yassinebkr/dmx-controller/docs/xiaorp2040_pinout.jpg

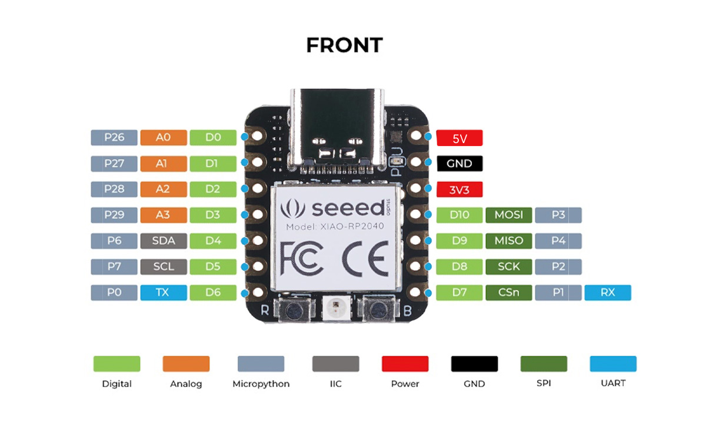
docs/xiaorp2040_pinout.jpg
