yassinebkr/dmx-controller/docs/Fiche presentation projet E62 - 0 Extensions DMX.pdf

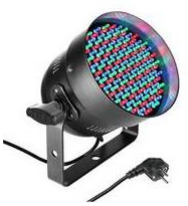
[picture p2: figure]
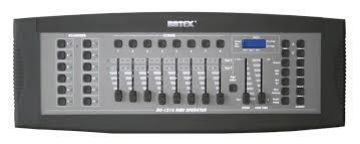
[picture p3: figure]

BTS CIEL : Dossier de validation de projet U62

BTS CIEL Option Electronique et Réseaux Projet technique : U62 | Session 2026
Etablissement : Lycée Jules FERRY - Cannes | Académie : ☑ Nice ☐ Corse

## Titre du projet Extensions DMX

Nouveau projet : ☐Oui ☑Non Partenaire professionnel

Raison sociale

Professeurs responsables

- KERNEN Elisabeth
- BENDIAF Mohamed
- ROQUES Aurélien

____________________________________________________________________________________

### Présentation générale du système supportant le projet :

Les éclairages de scènes utilisent différents
équipements électriques qui peuvent être
commandés grâce à un bus DMX.

____________________________________________________________________________________

### Analyse de l’existant :

L’ensemble des commandes est assurée par une
console DMX

____________________________________________________________________________________

### Expression du besoin :

Le client désire développer des extensions qui vont permettre :

- De réaliser des commandes individuelles de chaque éléments qui constitue le portique
- De rajouter un panneau lumineux commandé en DMX
- De connaitre la consommation instantanée et globale de l’installation
- De tester le bus DMX et d’analyser la trame

## Parties non étudiées en 2023

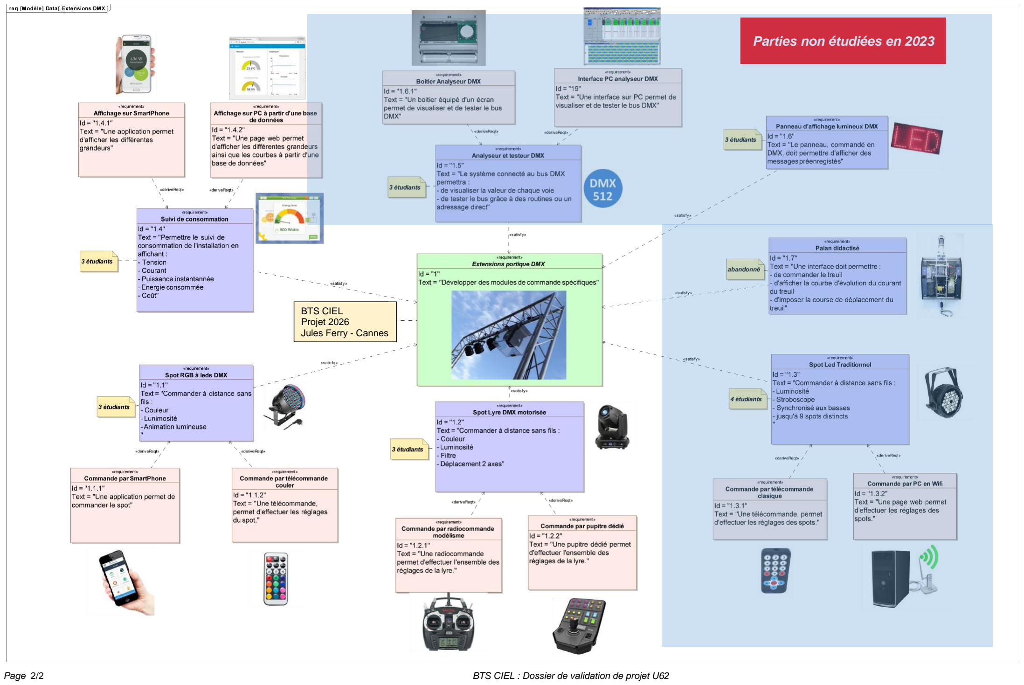
[picture p4: page 2]

Page 2/2 | BTS CIEL : Dossier de validation de projet U62

BTS CIEL
Projet 2026
Jules Ferry - Cannes
