yassinebkr/dmx-controller/tests/test_combined.py

# test_combined.py -- OLED + Joystick + Resistor-ladder buttons combined
# ======================================================================
# Shows joystick + button-ladder state on the OLED using fast direct
# framebuffer writes.
#
# Encoder is INTENTIONALLY excluded from this test. Rationale:
# test_ec11.py confirms the EC11 decodes cleanly on its own with simple
# digitalio polling at ~1 ms. Combining it with the joystick here pushes
# OLED redraws into every loop iteration (joystick ADC values change
# constantly), which stretches each iteration to ~10-15 ms -- longer
# than one encoder A/B phase, so quadrature direction becomes unreliable.
# The real DMX controller UI updates on slower events (menu changes,
# XBee replies, button presses) rather than continuous analog values, so
# the encoder will get the timing it needs in the main application. This
# test only validates joystick + buttons + OLED coexistence.
#
# Requires: adafruit_ssd1306.mpy in lib/, font5x8.bin at CIRCUITPY root
# Wiring: A0=JoyX, A1=JoyY, A2=JoyZ, A3=Buttons, D4=SDA, D5=SCL
# Calibration: run test_joystick.py first to get CAL_X/Y/Z values

import board
import busio
import analogio
import time
import adafruit_ssd1306

# -- Setup -------------------------------------------------------------
# 1MHz I2C -- SSD1306 handles it (84 FPS raw transfer proven)
i2c = busio.I2C(scl=board.D5, sda=board.D4, frequency=1_000_000)
oled = adafruit_ssd1306.SSD1306_I2C(128, 64, i2c, addr=0x3C)

joy_x = analogio.AnalogIn(board.A0)
joy_y = analogio.AnalogIn(board.A1)
joy_z = analogio.AnalogIn(board.A2)
btn_adc = analogio.AnalogIn(board.A3)

# -- Load font ---------------------------------------------------------
try:
    with open("font5x8.bin", "rb") as f:
        raw = f.read()
    # font5x8.bin may have a 2-byte header (1282 bytes instead of 1280)
    if len(raw) == 1282:
        FONT = raw[2:]
    else:
        FONT = raw
except OSError:
    print("ERROR: font5x8.bin not found on CIRCUITPY root!")
    raise SystemExit

# -- Fast framebuffer text ---------------------------------------------
buf = oled.buf
BUF_START = 0

def fast_text(text, x, page):
    """Write text directly to framebuffer -- 13x faster than oled.text()."""
    offset = BUF_START + page * 128 + x
    for ch in text:
        idx = ord(ch) * 5
        if offset + 5 > len(buf):
            break
        buf[offset] = FONT[idx]
        buf[offset + 1] = FONT[idx + 1]
        buf[offset + 2] = FONT[idx + 2]
        buf[offset + 3] = FONT[idx + 3]
        buf[offset + 4] = FONT[idx + 4]
        offset += 6  # 5px char + 1px gap

def clear_pages(start, end):
    """Clear a range of pages (8px rows each)."""
    begin = BUF_START + start * 128
    stop = min(BUF_START + (end + 1) * 128, len(buf))
    for i in range(begin, stop):
        buf[i] = 0

# -- Joystick calibration (from test_joystick.py) ---------------------
CAL_X = (489, 31979, 63522)
CAL_Y = (384, 31492, 63666)
CAL_Z = (438, 3490, 36000)
DEADZONE_PCT = 8

# -- Button thresholds (resistor ladder on A3, 2.2k pull-up) ---------
BUTTONS = [
    ("B1", 0,     2978),
    ("B2", 2979,  9626),
    ("B3", 9627,  16887),
    ("B4", 16888, 23523),
    ("B5", 23524, 31339),
    ("B6", 31340, 39005),
    ("B7", 39006, 45707),
    ("B8", 45708, 57525),
]
NO_PRESS = 57525

# -- Helpers -----------------------------------------------------------

def read_joy(pin):
    return pin.value

def identify_button(val):
    for name, low, high in BUTTONS:
        if low <= val <= high:
            return name
    return "---" if val > NO_PRESS else "???"

def map_cal(raw, cal):
    """Map raw ADC to -99..+99 using (min, center, max) calibration."""
    cal_min, cal_center, cal_max = cal
    range_low = cal_center - cal_min
    range_high = cal_max - cal_center
    dz_low = int(range_low * DEADZONE_PCT / 100)
    dz_high = int(range_high * DEADZONE_PCT / 100)

    if cal_center - dz_low <= raw <= cal_center + dz_high:
        return 0
    if raw < cal_center - dz_low:
        effective = cal_center - dz_low - raw
        full_range = range_low - dz_low
        return max(-99, -int(effective * 99 / full_range)) if full_range > 0 else 0
    else:
        effective = raw - (cal_center + dz_high)
        full_range = range_high - dz_high
        return min(99, int(effective * 99 / full_range)) if full_range > 0 else 0

def num_to_str(n):
    """Format number as +XX or -XX with padding."""
    if n >= 0:
        s = "+" + str(n)
    else:
        s = str(n)
    while len(s) < 4:
        s = " " + s
    return s

# -- Page layout -------------------------------------------------------
PG_HEAD = 0
PG_SEP  = 1
PG_XY   = 2
PG_Z    = 3
PG_DIR  = 4
PG_BTN  = 7

# -- Draw static header (once) ----------------------------------------
clear_pages(0, 7)
fast_text("DMX Controller", 0, PG_HEAD)
fast_text("----------------", 0, PG_SEP)
oled.show()

# -- Main loop ---------------------------------------------------------
print("Combined test (joystick + buttons + OLED) -- Ctrl+C to stop")

press_count = 0
last_btn = "---"

try:
    while True:
        btn = identify_button(btn_adc.value)
        if btn != "---" and btn != "???" and last_btn == "---":
            press_count += 1
        last_btn = btn

        jx = map_cal(read_joy(joy_x), CAL_X)
        jy = map_cal(read_joy(joy_y), CAL_Y)
        jz = map_cal(read_joy(joy_z), CAL_Z)

        # Clear and redraw dynamic pages
        clear_pages(PG_XY, PG_BTN)

        # Joystick XY
        fast_text("X:" + num_to_str(jx) + " Y:" + num_to_str(jy), 0, PG_XY)

        # Z rotation with bar
        zabs = abs(jz) // 10
        if jz > 0:
            fast_text("Z: CW  " + "=" * zabs, 0, PG_Z)
        elif jz < 0:
            fast_text("Z: CCW " + "=" * zabs, 0, PG_Z)
        else:
            fast_text("Z: ---", 0, PG_Z)

        # Direction
        dx = "R" if jx > 15 else ("L" if jx < -15 else "-")
        dy = "U" if jy > 15 else ("D" if jy < -15 else "-")
        fast_text("Dir: " + dx + " " + dy, 0, PG_DIR)

        # Button
        fast_text("Btn:" + btn + " #" + str(press_count), 0, PG_BTN)

        oled.show()

        time.sleep(0.001)

except KeyboardInterrupt:
    clear_pages(0, 7)
    fast_text("Test done!", 0, 2)
    fast_text("Btn presses: " + str(press_count), 0, 3)
    oled.show()
    print("\nDone. " + str(press_count) + " btn presses.")
