yassinebkr/dmx-controller/(commit log)

2026-03-18 Initial commit: test scripts for OLED + button ladder
    - test_oled.py: SSD1306 I2C display test (fill, text, shapes, counter)
    - test_buttons.py: ADC raw monitor + threshold-based detection
    - test_combined.py: integrated OLED + button display
    - README with full pin budget and resistor ladder specs
2026-03-18 added datasheets and docs
    [XIAO-RP2040-pinout_sheet.xlsx]
2026-03-18 Add joystick test + update combined test
    - test_joystick.py: raw monitor (Phase 1) + mapped values with deadzone (Phase 2)
    - compass direction labels, -100 to +100 mapping
    - test_combined.py: now includes joystick (X/Y/Z mapped) + buttons + OLED
    - direction indicator, press counter, serial + OLED output
    - Joystick on A0/A1/A2, buttons on A3, OLED on D4/D5
2026-03-18 Fix joystick: calibration routine + asymmetric mapping
    Joystick pots don't center at half-VCC and ranges are asymmetric.
    test_joystick.py now has 3 phases:
    Phase 1: raw monitor (10s)
    Phase 2: auto-calibration (rest=center, then move to extremes)
    Phase 3: mapped output using actual min/center/max
    test_combined.py: uses CAL_X/Y/Z tuples (min, center, max)
    - paste values from test_joystick.py Phase 2
    - deadzone as % of range per side (8% default)
    - Z axis shows CW/CCW with bar indicator
    [test_combined.py, test_joystick.py]
2026-03-18 Set calibrated joystick values from hardware test
    CAL_X = (489, 31979, 63522)
    CAL_Y = (384, 31492, 63666)
    CAL_Z = (438, 3490, 46071)
    Note: Z rotation causes slight X/Y crosstalk (~-10/-12),
    physical pot interference — not a software issue.
    [test_combined.py]
2026-03-18 Fix Z-axis: lower max to 36000 for sustained CW range
    Calibration captured a spike at 46071 but sustained CW rotation
    only reaches ~36000, making +99 unreachable. Adjusted max so
    full CW rotation maps to full +99.
    [test_combined.py]
2026-03-25 corrected xbee_setup send_at func
    [xbee_setup.py]
2026-03-25 Comprehensive comments on all files, fix MY_ADDR to 4-digit hex (0001)
    [test_xbee.py, xbee_setup.py]
2026-03-25 Add comprehensive comments to all scripts, fix MY_ADDR to hex format (0001)
    [test_xbee.py, xbee_setup.py]
2026-03-25 corrected xbee setup values : from 000x to x
    [xbee_setup.py]
2026-03-25 Faster loop: 2-sample joystick, 3-sample buttons, no sleep, ~30fps
2026-03-25 I2C 400kHz for faster OLED, single-sample button read
2026-03-25 Add displayio OLED test with FPS counter -- native C driver benchmark
2026-03-25 Add OLED speed benchmark: isolate I2C vs rendering vs text bottleneck
2026-03-25 Fast OLED test: direct framebuffer writes bypass slow pixel-by-pixel text()
2026-03-25 test_combined: fast framebuffer rendering, 1MHz I2C -- ~40 FPS
2026-03-25 Fix font5x8.bin 2-byte header offset -- was causing garbled text
    [test_combined.py, test_oled_fast.py]
2026-03-25 Fix buffer offset: skip 1-byte I2C header (0x40) in oled.buf
    [test_combined.py, test_oled_fast.py]
2026-03-25 Fix IndexError: cap clear_pages to buffer length
    [test_combined.py, test_oled_fast.py]
2026-03-25 Fix BUF_START=0: oled.buf has no header, full 1024-byte framebuffer
    [test_combined.py, test_oled_fast.py]
2026-05-26 Add wireless protocol spec (PROTOCOL.md v1.0) + update README
    - Protocol: Mode 2, 10-byte binary packet, 20Hz delta-filtered
    - DMX mapping: Pan/Tilt/Fine/Speed/Color/Gobo/Shutter
    - Joystick: velocity mode (spring-return compatible)
    - Encoder: color cycle + shutter cycle on push
    - Buttons: color/gobo/shutter shortcuts
    - Updated README with split PCB architecture, encoder pinout
2026-05-27 feat: protocole DMX sans fil complet + squelette récepteur Arduino
    - src/main.py: émetteur CircuitPython (mode VELOCITY, joystick + encodeur + boutons)
    - src/recepteur_squelette.ino: squelette Arduino avec TODOs et commentaires français
    - docs/GUIDE_RECEPTEUR.md: documentation complète du protocole en français
    - tests/test_combined.py: test combiné hardware (modifié)
    Protocol v1.0: 10-byte packet, 20Hz active + 500ms heartbeat, XOR checksum
2026-05-28 Update resistor values: 22.2k pull-up, add EC11 test, fix B4-B8 thresholds
    - New ladder: idle 22.2k, B1 0Ω, B2 220Ω, B3 560Ω, B4 1kΩ, B5 1.5kΩ, B6 2.7kΩ, B7 3.9kΩ, B8 6.8kΩ
    - Updated test_buttons.py and test_combined.py with correct 16-bit ADC thresholds
    - Added test_ec11.py for PEC12R rotary encoder (D8/D9/D10)
    - Updated README with new voltage table and status
    [test_buttons.py, test_combined.py, test_ec11.py]
2026-05-28 Fix README pin table: 2k -> 22.2k pull-up
2026-05-28 Fix: pull-up is 2.2k not 22.2k — recalculate all thresholds
    - test_buttons.py: corrected ADC thresholds (much wider gaps now)
    - test_combined.py: updated BUTTONS array and NO_PRESS
    - README.md: fixed voltage table, pin table, and status note
    [test_buttons.py, test_combined.py]
2026-05-28 Fix README checklist (2.2k not 22.2k), integrate EC11 into test_combined
    - README.md: fixed checklist resistor values + test_buttons comment
    - test_combined.py: added encoder pins (D8/D9/D10), encoder state tracking,
    encoder position + button count on OLED display
    [test_combined.py]
2026-05-28 Update main.py button thresholds for 2.2k pull-up resistor ladder
    - Recalculated all 8 button thresholds based on 2.2k pull-up
    - B1: 0-2978, B2: 2979-9626, B3: 9627-16887, B4: 16888-23523
    - B5: 23524-31339, B6: 31340-39005, B7: 39006-45707, B8: 45708-57525
    - Added NO_PRESS_THRESHOLD = 57525
2026-05-28 Fix encoder lag and button in test_combined.py
    - 4x quadrature decoding (both edges on both channels) for reliability
    - Added enc_last_b state tracking
    - 50ms debounce on encoder pushbutton
    - 1ms time.sleep() in main loop to match test_ec11.py timing
    - Prevents CPU spin and missed transitions during OLED I2C traffic
    [test_combined.py]
2026-05-28 Add test_ec11_v3.py diagnostic version
    - Idle state wiring check (all pins should read HIGH)
    - Shows raw A/B/BTN values on every change
    - Detects stuck-low pins (shorted to GND)
    - Helps diagnose encoder wiring issues
2026-05-28 Replace test_ec11 with diagnostic version, delete v2/v3
    - test_ec11.py: now shows idle pin state check + raw values on every change
    - Deleted test_ec11_v2.py and test_ec11_v3.py
    - Helps diagnose stuck-low pins and wiring issues
    [test_ec11.py]
2026-05-28 Add Phase 1 raw button monitor to test_ec11.py
    - Phase 1: continuous raw BTN value display (0.1s interval)
    - Helps verify if CircuitPython sees the pin go LOW when pressed
    - Phase 2: full encoder + button test (same as before)
2026-05-28 Revert encoder to 1x decoding in test_combined.py
    - 4x decoding was too sensitive with OLED I2C traffic
    - Back to falling-edge-on-A (same as test_ec11 which works)
    - Removed enc_last_b state variable
    [test_combined.py]
2026-05-28 Add REPL debug logging to test_combined.py encoder
    - DEBUG flag (set to True to enable)
    - Logs encoder delta, position, raw A/B values on every rotation
    - Logs button press/release with count
    - Helps diagnose encoder weirdness in combined test
2026-05-28 Add 5ms debounce to encoder in test_combined.py
    - Prevents multiple counts per detent from mechanical bounce
    - Ignores edges within 5ms of last encoder event
    - Should fix the '11 counts for 11 detents' issue
    [test_combined.py]
2026-05-28 Switch to 2x encoder decoding + reduce debounce to 3ms
    - 2x: catches both rising and falling edges on A (twice the opportunities)
    - Reduced debounce from 5ms to 3ms (less likely to miss fast rotations)
    - Direction: A==B → CW, A!=B → CCW
2026-05-28 Full quadrature state machine for encoder (4x decoding)
    - Tracks both A and B, uses 4-bit state transitions
    - Valid CW: 00->01->11->10->00
    - Valid CCW: 00->10->11->01->00
    - Invalid transitions (bounce) are ignored
    - 2ms debounce to prevent multiple counts
    [test_combined.py]
2026-05-28 Remove encoder debounce — match test_ec11.py proven logic
    - No software debounce (EC11 mechanical detents handle it)
    - Track both A and B, act on A edges only
    - Same logic as test_ec11.py which works perfectly
2026-05-28 resolved the encoder timing issue, TBT
    [test_combined.py]
2026-05-29 reverted rotaryio tries, classic digitalio way is more reliable for our case
    [test_combined.py, test_ec11.py]
2026-06-02 udpated main : screen render reparated from packets sending, applied encoder + screen framerate fixes(from unit tests)
    [main.py]
